wulffern/tt06-sar/media/adcs.pdf

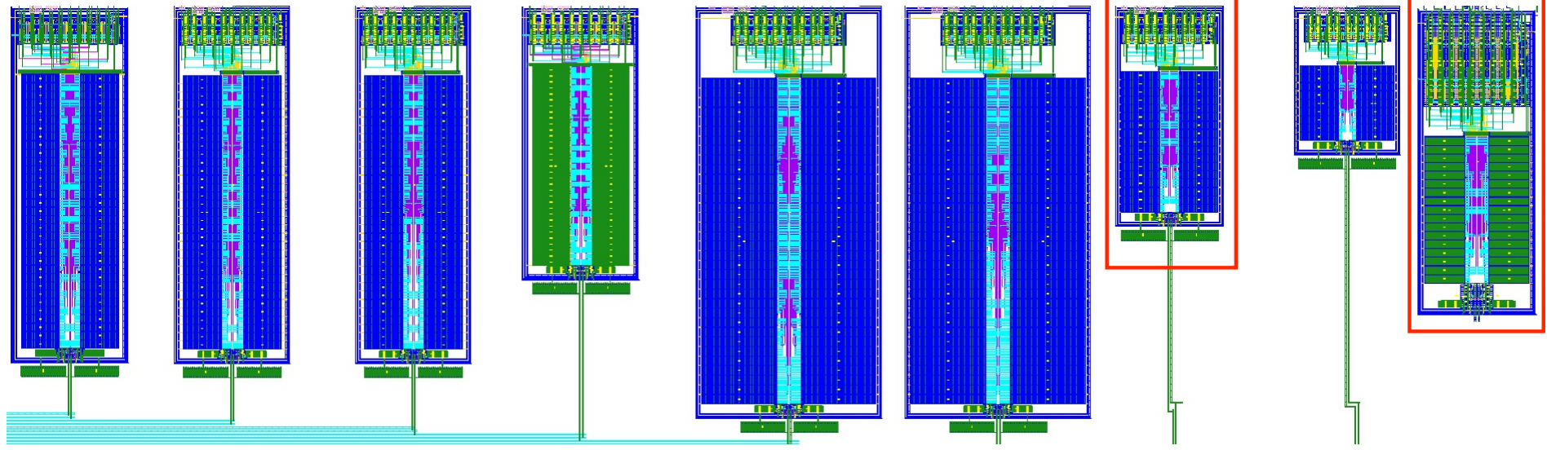
[picture p7: figure]

10-bit Prototype 14-08-2014 10-bit second order compensated CDAC

10-bit common centroid CDAC

10-bit f**k recommended DRC rules 11-bit second order compensated CDAC 11-bit common centroid CDAC

9-bit
8-bit

9-bit IO voltage
