wulffern/tt06-sar/media/cnano.pdf

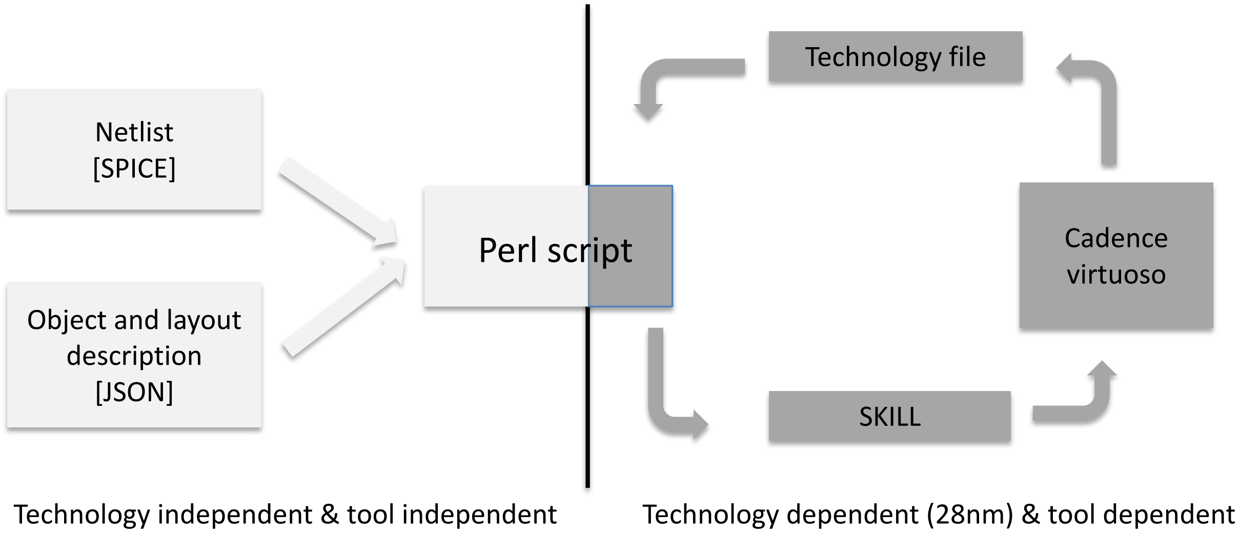
[picture p8: page 1]

Netlist
[SPICE]

Object and layout
description
[JSON]

Technology file

SKILL

Cadence
virtuoso

Technology independent & tool independent Technology dependent (28nm) & tool dependent

### Perl script
