wulffern/tt06-sar/docs/sar.pdf

# 8-bit SAR ADC on Tiny Tapeout

# tt06-sar (https://github.com/wulffern/tt06-sar)

Carsten Wulff 2024 | 1

# Goal

# Walk you through tt06-sar, and the steps necessary to tapeout on TinyTapeout

Carsten Wulff 2024 | 2

# Idea

Carsten Wulff 2024 | 3

# Trigger (2009)

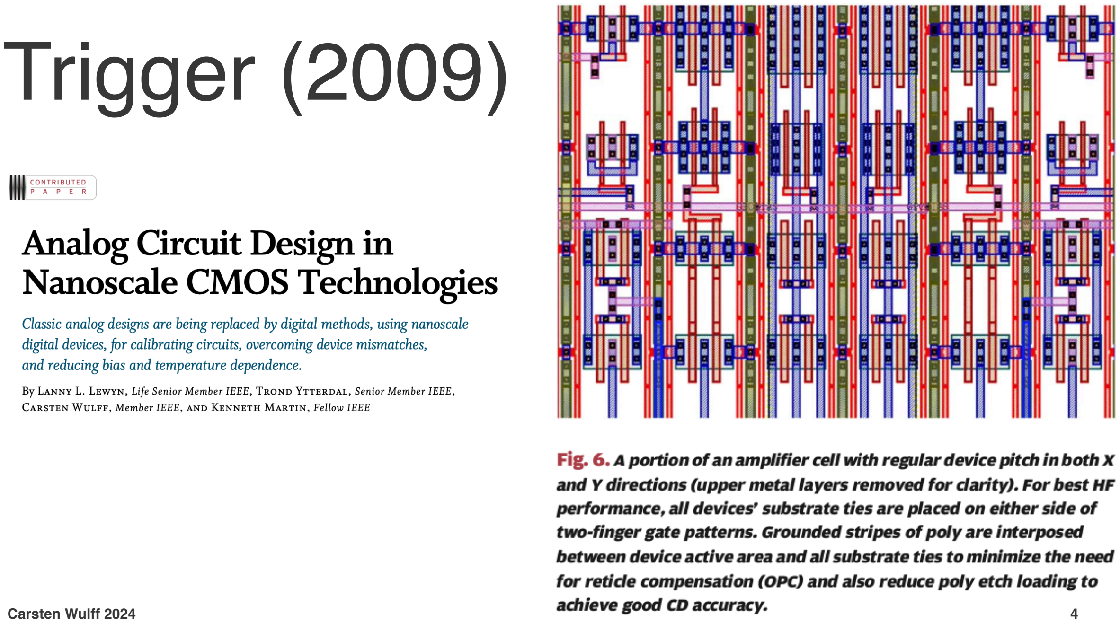
[picture p11: page 4]

Carsten Wulff 2024 | 4

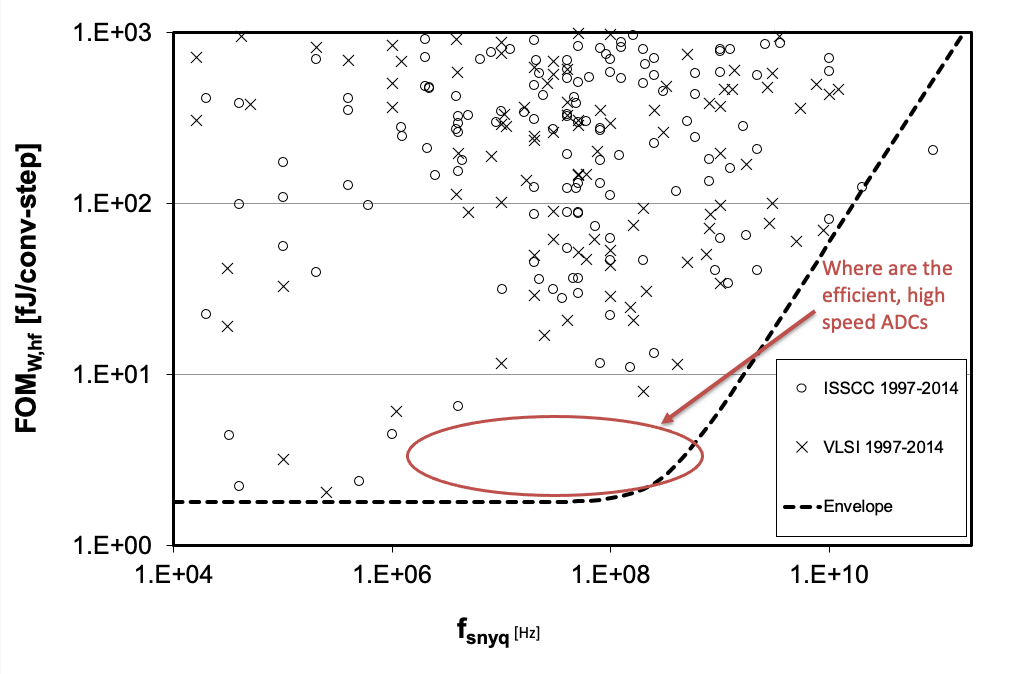
[picture p12: figure]

# Problem (2014)

Carsten Wulff 2024 | 5

# Circuit

Carsten Wulff 2024 | 6

### SAR Logic

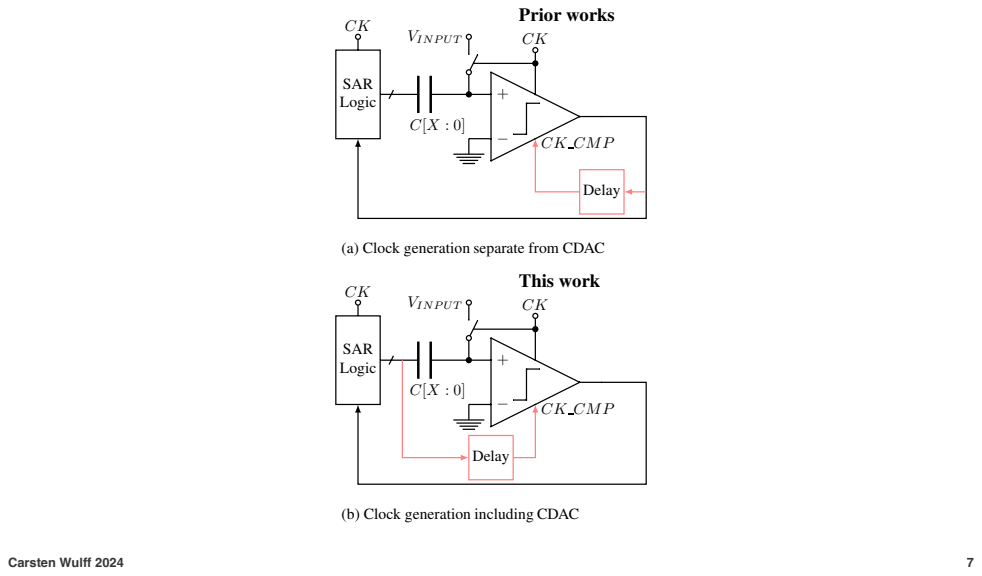
[picture p13: page 7]
Prior works; VINPUT; CK CMP; Delay; This work; SAR Logic; Carsten Wulff 2024

(a) Clock generation separate from CDAC

(b) Clock generation including CDAC

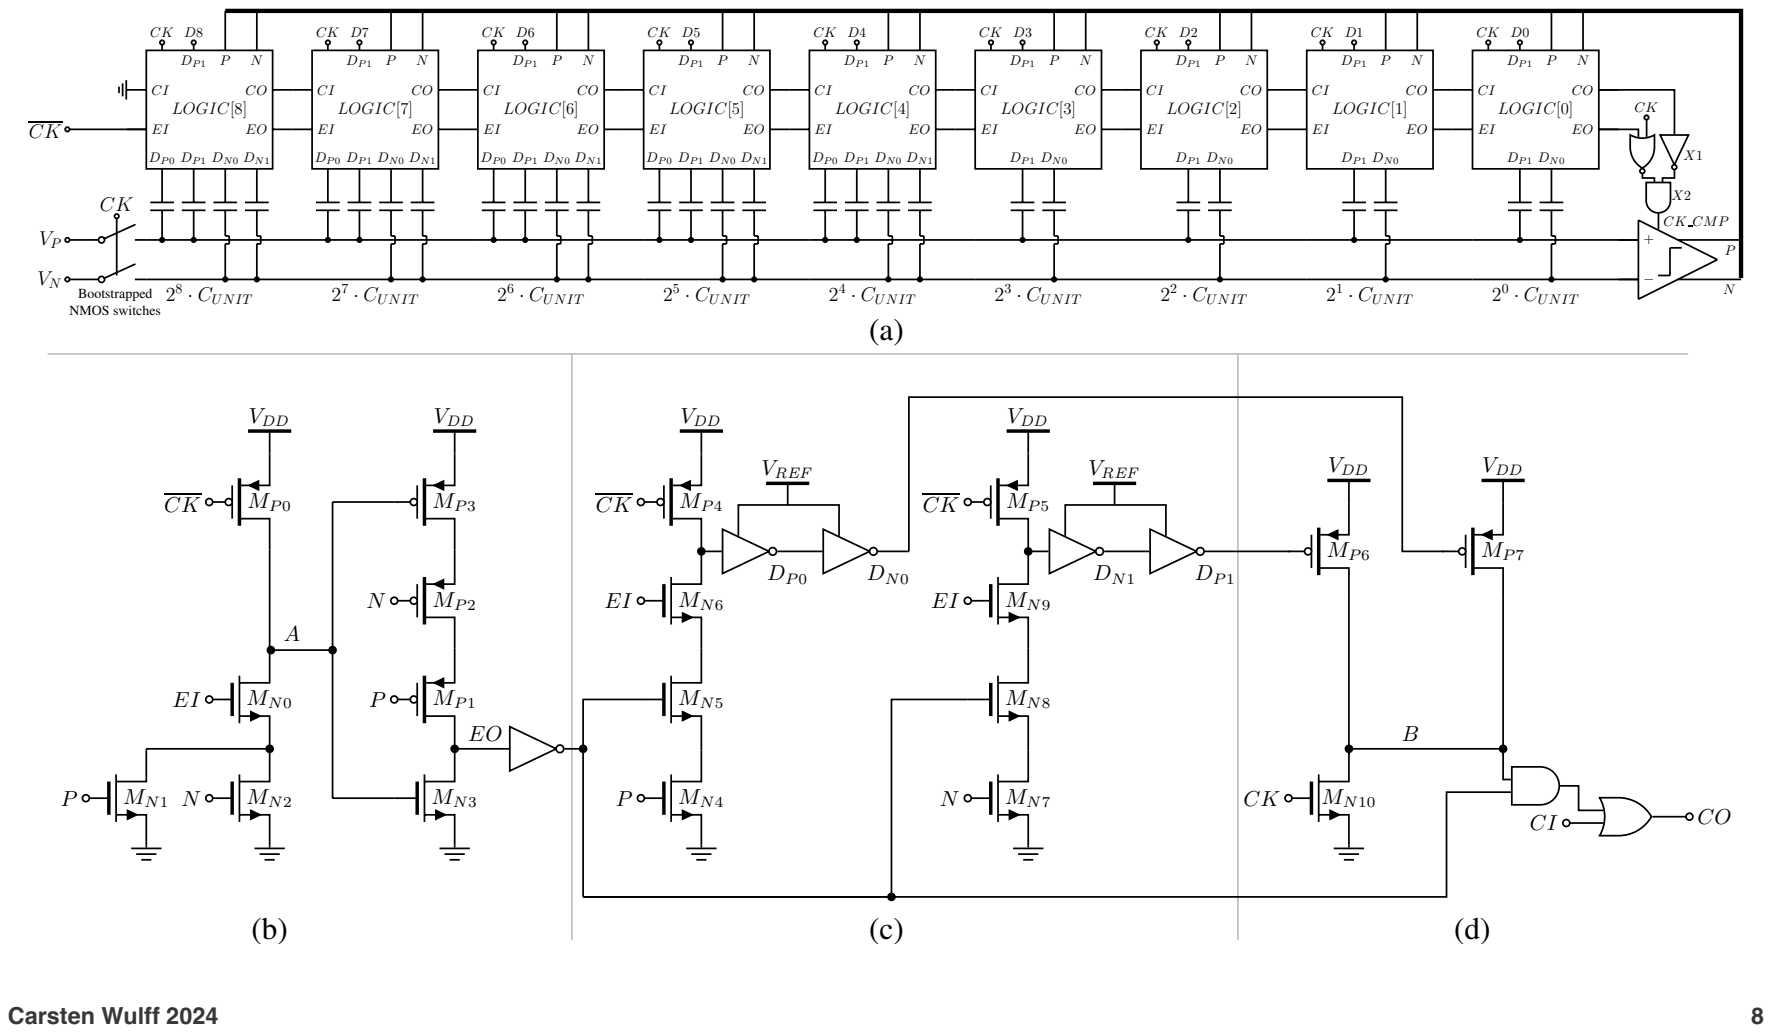
[picture p14: page 8]

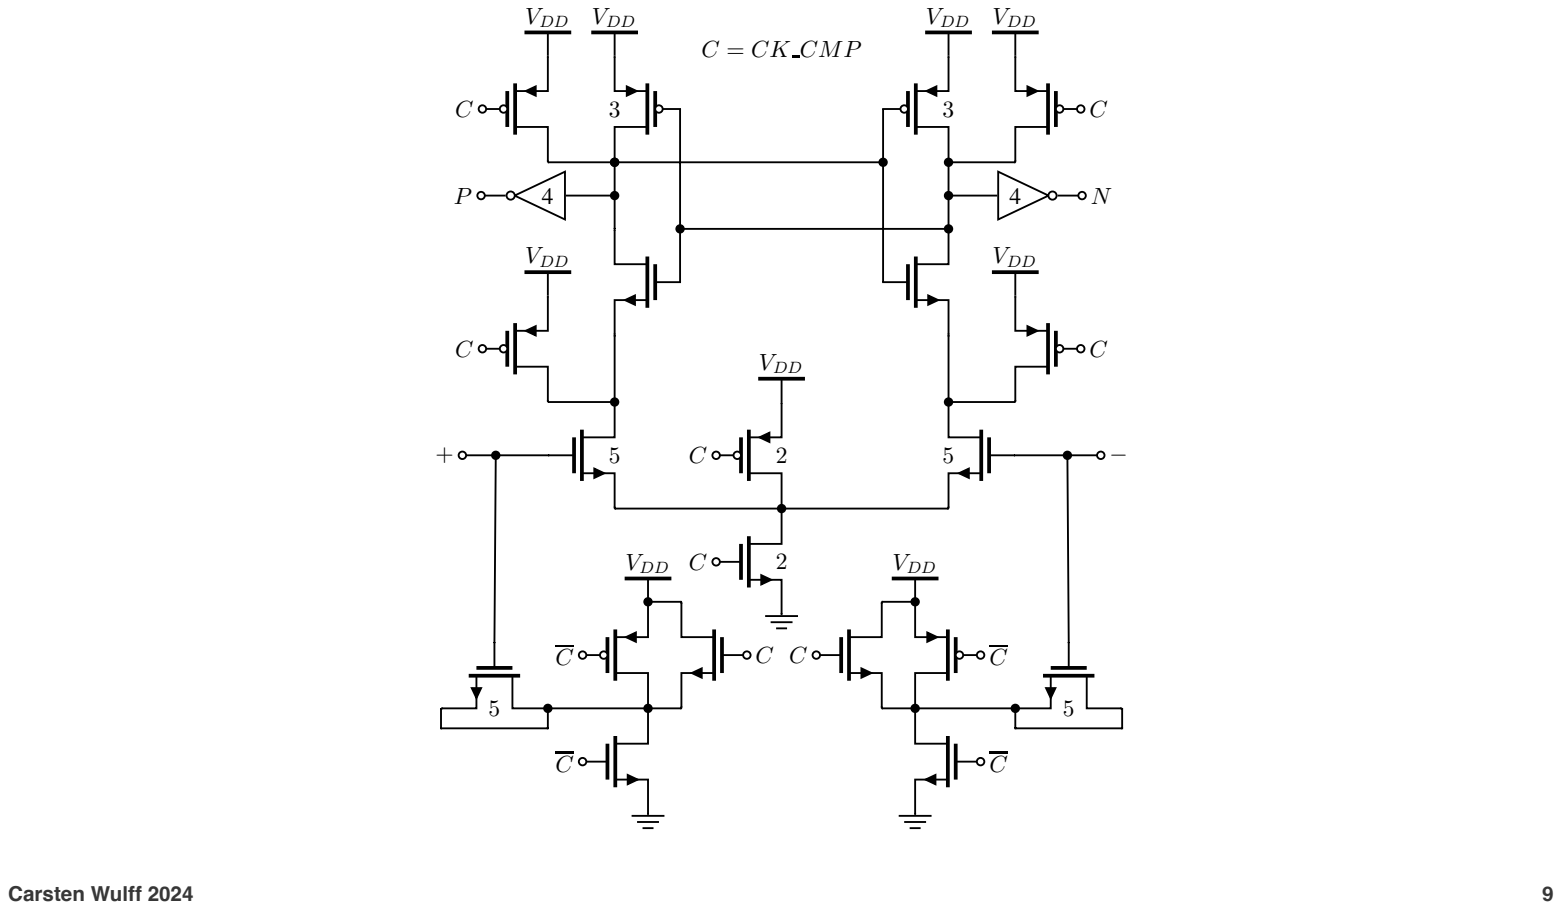
[picture p15: page 9]
C = CK CMP; VDD; Carsten Wulff 2024

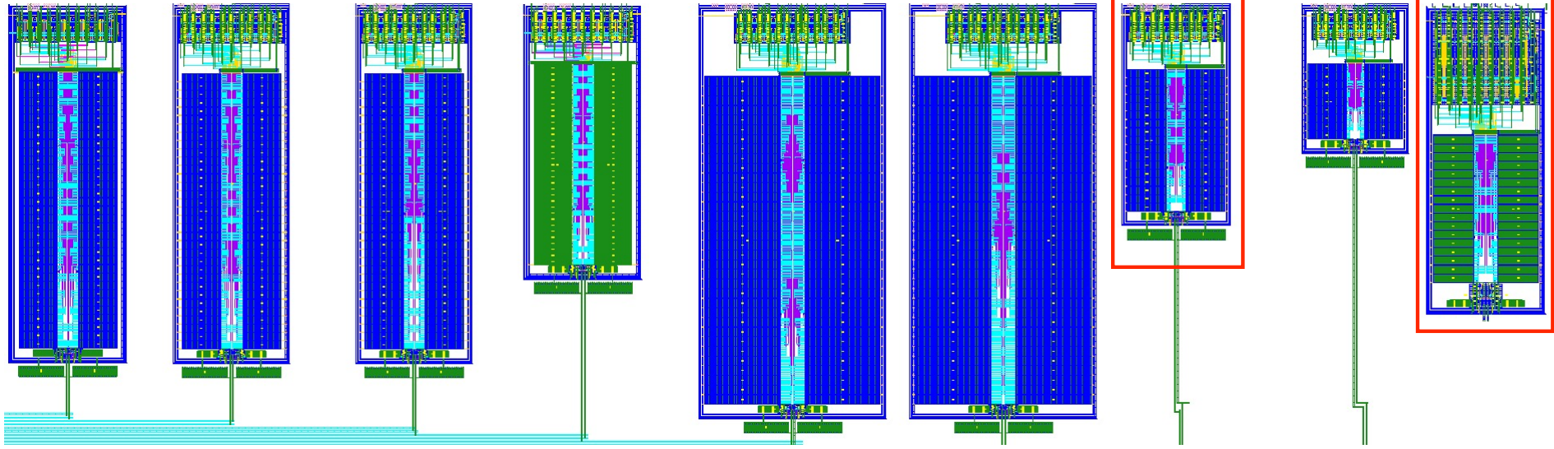
[picture p16: figure]

# 10-bit Prototype 14-08-2014 10-bit second order compensated CDAC

# 10-bit common centroid CDAC

# 10-bit f**k recommended DRC rules 11-bit second order compensated CDAC 11-bit common centroid CDAC

# 9-bit 8-bit

# 9-bit IO voltage

Carsten Wulff 2024 | 10

Weaver [5] | Harpe [9] | Patil [10] | Liu [11] | This work
Technology (nm) | 90 | 90 | 28 FDSOI | 28 | 28 FDSOI
Fsample (MS/s) | 21 | 2 | No sampling | 100 | 2 | 20

# Core area (mm²

) | 0.18 | 0.047 | 0.0032 | 0.0047 | 0.00312
SNDR (dB) | 34.61 | 57.79 | 40 | 64.43 | 46.43 48.84
SFDR (dBc) | 40.81 | 72.33 | 30 | 75.42 | 61.72 63.11
ENOB (bits) | 5.45 | 6.7 - 9.4 | 6.35 | 10.41 | 7.42 | 7.82
Supply (V) | 0.7 | 0.7 | 0.65 | 0.9 | 0.47 | 0.69
Pwr (µW) | 1110 | 1.64 -3.56 | 24 | 350 | 0.94 | 15.87
Compiled | Yes | No | No | No | | Yes
FoM (fJ/c.step) | 838 | 2.8 - 6.6 | 3.7 | 2.6 | 2.7 | 3.5
Carsten Wulff 2024 | 11

# Compilation

Carsten Wulff 2024 | 12

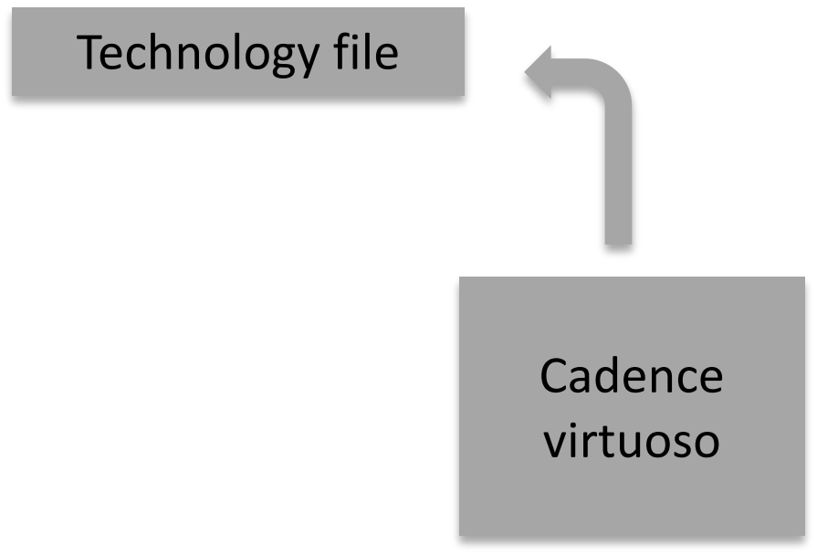
[picture p17: figure]
Technology file; Cadence virtuoso
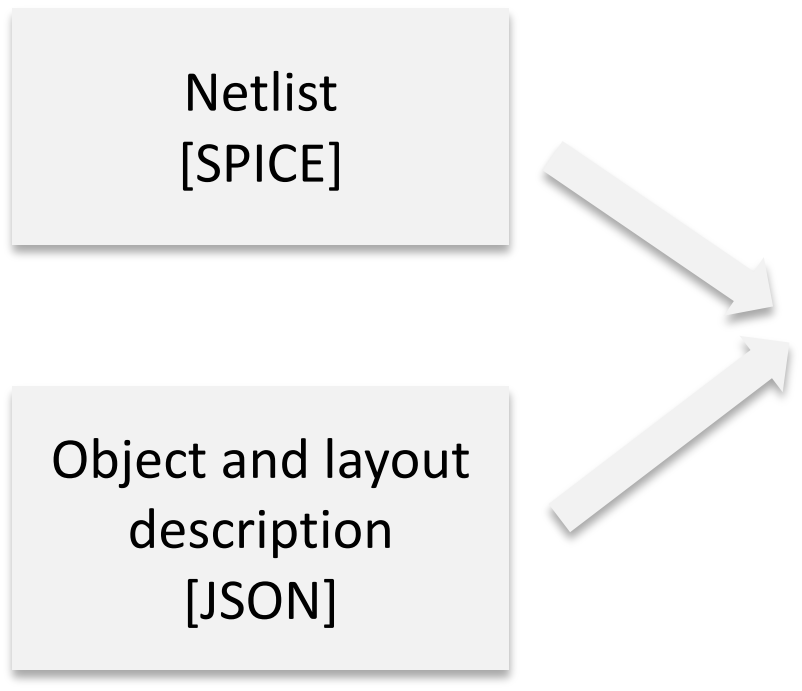
[picture p18: figure]
Netlist [SPICE]; Object and layout description [JSON]

# SKILL

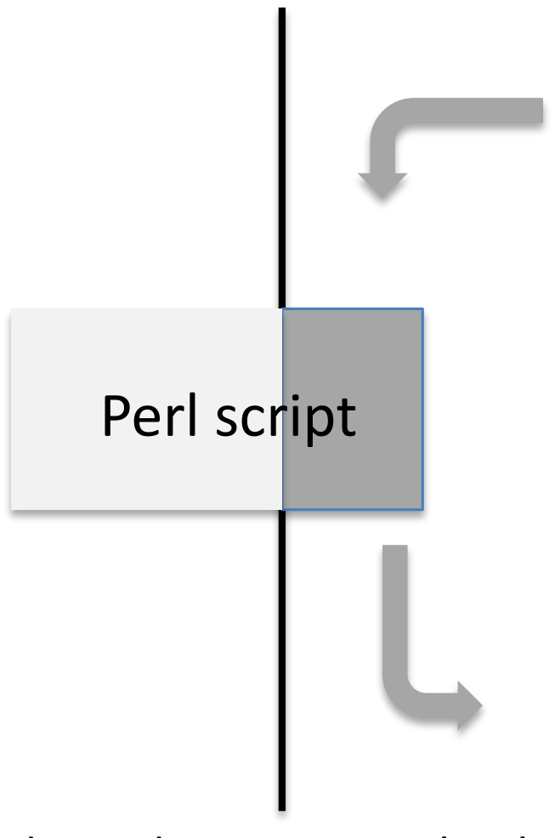
[picture p19: figure]
Perl script

Technology independent & tool independent | Technology dependent (28nm) & tool dependent
16 k Perl lines. Ported to C++ for speed | ciccreator (https://github.com/wulffern/ciccreator)
Carsten Wulff 2024 | 13

{ "name" : "DMOS" ,
"class" : "Gds::GdsPatternTransistor", "yoffset": -0.5,
"widthoffset" : -1,

### "fillCoordinatesFromStrings" : [

[ | "OD",
| "------------------xxxx",
| "----xCxC----------xCxC",
| "----xxxx----------xxxx",
| "----xCxC----------xCxC",
| "------------------xxxx"
],
[ | "PO",
| "-mmmmmmmmmmmmm--------",
| "----------------------",
| "-mmmmmmmmmmcxc--------",
| "----------------------",
| "-mmmmmmmmmmmmm--------"
],
[ | "M1",

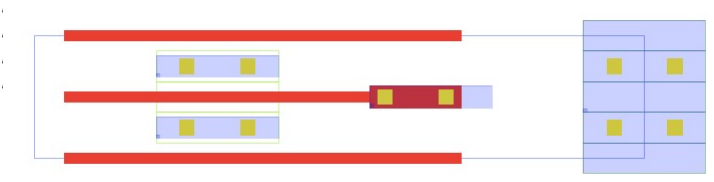
[picture p20: figure]

| "------------------xxxx",
| "----wDww----------xxxx",
| "-----------wGww---xBxx",
| "----wSww----------xxxx",
| "------------------xxxx"
]
]
}

# - Structure and any other property is described in JSON (JavaScript Object Notation) - “name” is the name of the cell - “class” defines which object to use - All other classes in the JSON object refer to

## object methods (there are some special functions, but more on that

## later)

# - Convert a text string into a layout drawing - c = contact - C = center contact on rectangle left edge - x = fill rectangle - m = use minimum length poly - w = use “width” from techfile - DGSB = add ports

Carsten Wulff 2024 | 14

| | Vertical Grid
D | | | Horizontal Grid
| G | | | B

S

OD | PO | M CO | 1
Carsten Wulff 2024 | 15

{ "name": "IVX1_CV" ,
"symbol" : "inv",
"class" : "Layout::LayoutDigitalCell",

## "spice" : [

".subckt IVX1_CV A Y AVDD AVSS" , "MN0 Y A AVSS AVSS NCHDL",
"MP0 Y A AVDD AVSS PCHDL", ".ends IVX1_CV”],

## "addSchematicCoordinates" : {

"MN0" : [ 0.25, 0, "R0"],

## "MP0" : [0.25, 0.5, "R0”]

},

## "beforeRoute" : { "addDirectedRoutes" : [ ["M1","Y","MN:D-|--MP:D"], ["PO","A","MN:G-MP:G"] ]

},

## "afterRoute" : { "addPortOnRects" : [ ["A","M1", "MN0:G"] , ["Y", "M1", "MN0:D"]]

}
}

## What symbol to use, defaults to templates/skill/<name>.il LayoutDigitalCell has extra functions for digital cells, and will add

power rails.

## Connectivity defined by SPICE. SPICE subcircuit can be read from a separate file

## Help the schematic generator to place transistors so it’s easier to read schematics

## Find rectangle on device MN:D, and route in M1 to rectangle MP:D

using a left, up or down, left pattern.

## Add port for A on the gate of MN0

Carsten Wulff 2024 | 16

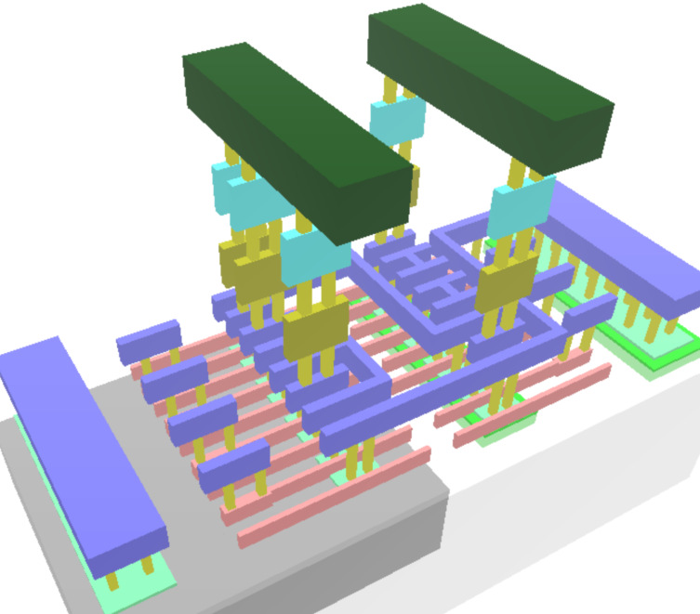
[picture p21: figure]
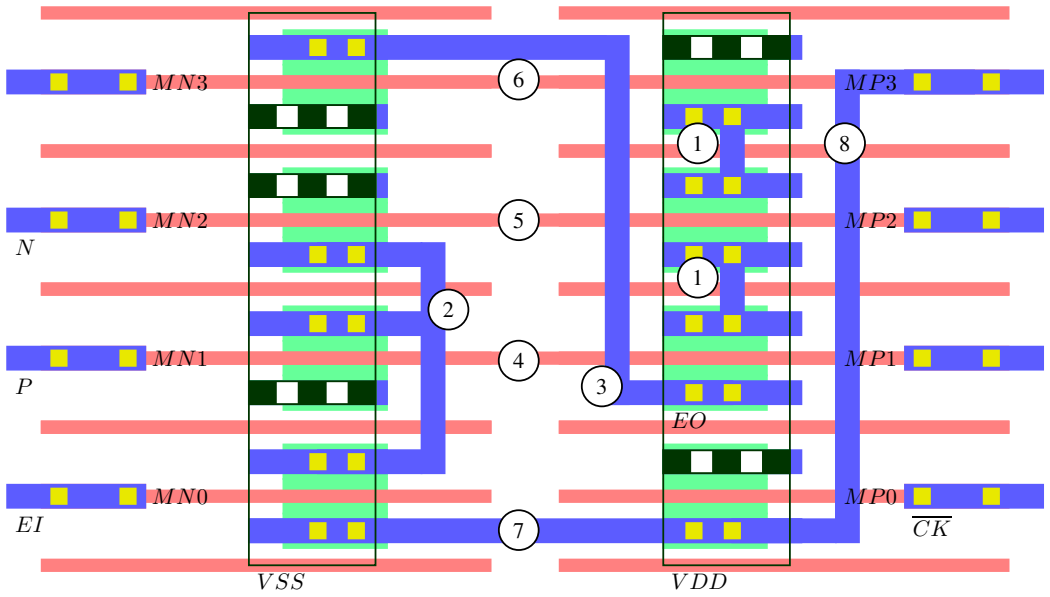
[picture p22: figure]

(d)

(a) (c)

{ "name": "SAREMX1_CV", "class" : "Layout::LayoutDigitalCell", "addConnectivityRoutes": [

["M1","N1|N2","||",""], | 1
["M1","N3","-|",""], | 2
["M1","EO","--|-","onTopR"] | 3
],
"addDirectedRoutes" : [
["PO","P","MN1:G-MP1:G"], | 4
["PO","N","MN2:G-MP2:G"], | 5
["PO","A","MN3:G-MP3:G"], | 6
["M1","A","MN0:S-MP0:S"], | 7
["M1","A","MP0:S-|--MP3:G"] | 8
]
}
}

(b)

.SUBCKT SAREMX1_CV P | N EI EO CK_N AVDD AVSS
MN0 N3 | EI | A | AVSS | NCHDL
MN1 N3 | P | AVSS AVSS | NCHDL
MN2 AVSS N | N3 | AVSS | NCHDL
MN3 EO | A | AVSS AVSS | NCHDL
MP0 AVDD CK_N A | AVSS | PCHDL
MP1 N2 | P | EO | AVSS | PCHDL
MP2 N1 | N | N2 | AVSS | PCHDL
MP3 AVDD A | N1 | AVSS | PCHDL
.ENDS
OD | PO | M CO | 1 | M2 | M3 | M4
Carsten Wulff 2024 | 17

# Since then

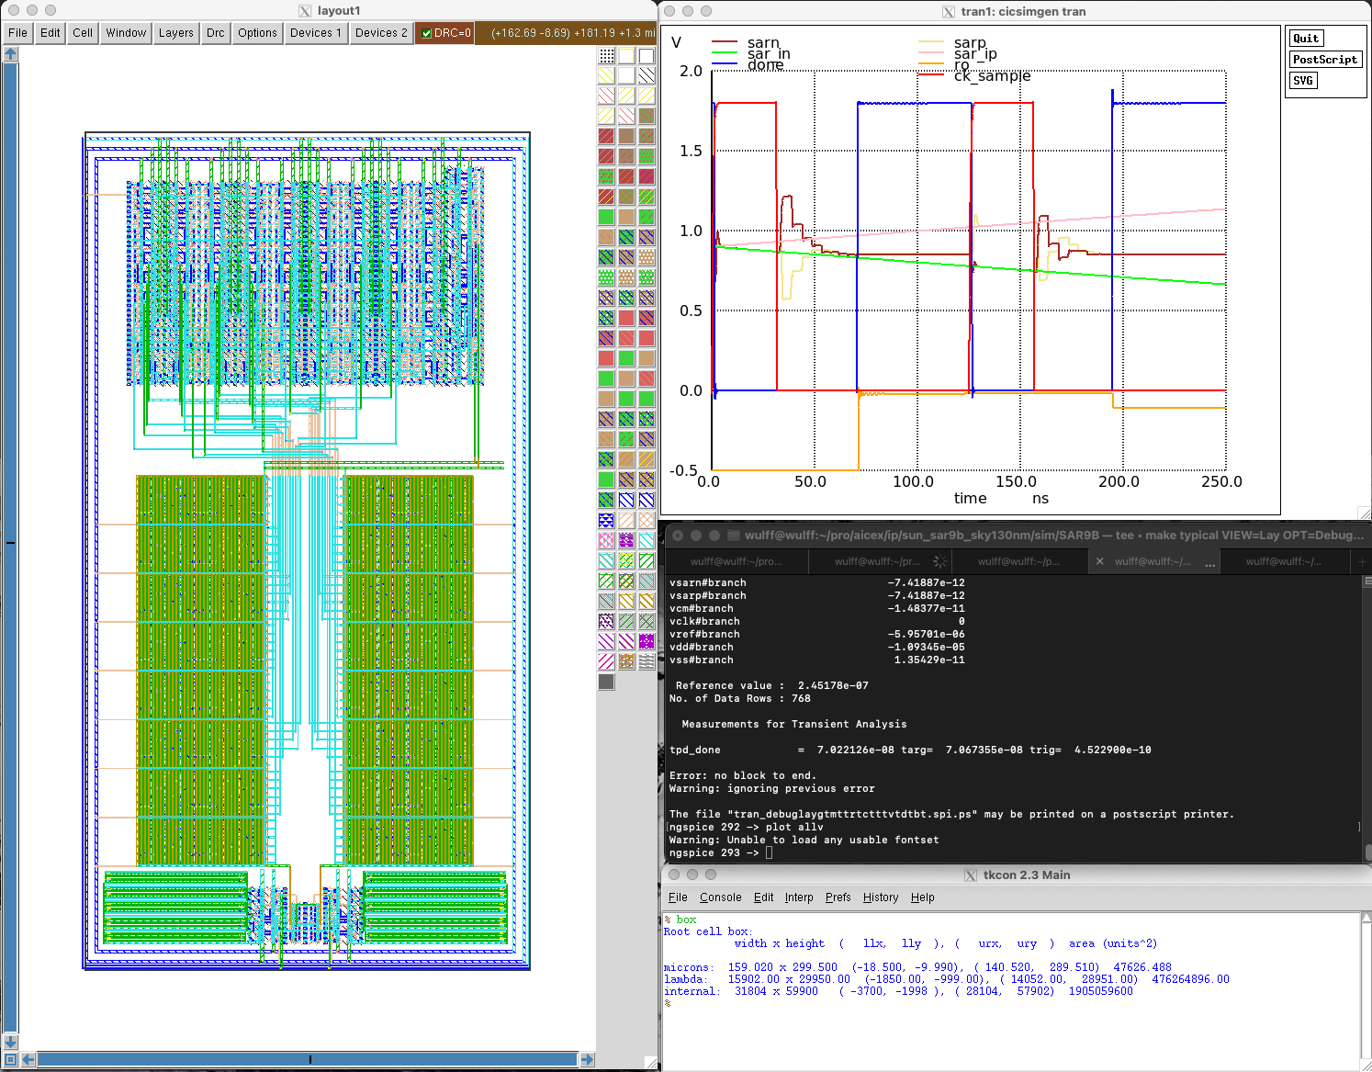
[picture p23: figure]

# Measured: 28 nm FDSOI, 55 nm Ported: 22 nm FDSOI, 22 nm, 28 nm, 65 nm, 130 nm

# 2022: There is an open source port to skywater 130nm! wulffern/sun_sar9b_sky130nm (https://github.com/wulffern/sun_sar9b_sky130nm)

Carsten Wulff 2024 | 18

# Super simple transistor was a good choice for portability

Carsten Wulff 2024 | 19

//sky130
{ "name" : "DMOS_BULKN" ,
"class" : "Gds::GdsPatternTransistor"

,
"abstract" :

1

,
"yoffset": -0.5

,
"widthoffset" : -0.5

,
"fillCoordinatesFromStrings" : [
[ | "OD" ,
| "-------------------"

,
| "----xxx------------"

,
| "----xxx------------"

,
| "----xxx------------"

,
| "-------------------"
],
[ | "M1" ,
| "----------------xxx"

,
| "----wDw---------xxx"

,
| "----------wGw---xBx"

,
| "----wSw---------xxx"

,
| "----------------xxx"
],
[ "NDIFFC"

,
| "-------------------"

,
| "----LTR------------"

,
| "-------------------"

,
| "----LTR------------"

,
| "-------------------"
]
] }

//28nm FDSOI
{ "name" : "DMOS" ,
"class" : "Gds::GdsPatternTransistor"

,
"yoffset": -0.5

,
"type": "pch"

,
"widthoffset" : -1

,
"fillCoordinatesFromStrings" : [ [ "OD"

,
"------------------xxxx"

,
"----xxK-----------xCxC"

,
"----xxx-----------xxxx"

,
"----xxK-----------xCxC"

,
"------------------xxxx"
],
[ "PO"

,
"-mmmmmmmmmmmmm--------"

,
"----------------------"

,
"-mmmmmmmmmmcxc--------"

,
"----------------------"

,
"-mmmmmmmmmmmmm--------"
],
[ "M1"

,
"------------------xxxx"

,
"----wDww----------xxxx"

,
"-----------wGww---xBxx"

,
"----wSww----------xxxx"

,
"------------------xxxx"
]
],
"afterNew" : {
"copyColumns" :[
{ "count" :

0, "offset" :

4

,"length" :

4

}
]
} }
Carsten Wulff 2024 | 20

# 2016 (Perl compiler)

{ "name": "SARCMPHX1_CV",
"description" : "Half a strong-arm comparator", "class" : "Layout::LayoutDigitalCell", "setYoffsetHalf" : "" ,
"rows" : 7,
"beforeRoute" : {
"addDirectedRoutes" : [ ["PO","VMR","MN6:G-MP6:G"], ["M1","VMR","MP4:G||MP6:G"], ["M1","CI","MN1:G||MN5:G"], ["M1","N2","MN1:D,MN3:D,MN5:D-|--MP1:D"], ["M1","N1","MN0:D,MN2:D|-MN4:D"], ["M1","N1","MN0:D-|--MP0:S"], ["M1","CO","MP3:D,MP5:D--|-MN6:D"], ["PO","CK","MN0:G-MP0:G"], ["M1","CK","MP0:G,MP1:G-|MP3:G"], ["M4","NC","MP2$:D--|--MP2:G"]
]
},
"afterRoute" : {
"addPortOnRects" : [ ["AVDD","M4" ], ["N1","M1","MN4:D"],
["N2","M1","MN5:D" ]]
}
}

# 2022 (C++ compiler)

{ "name": "SARCMPHX1_CV",
"description" : "Half a strong-arm comparator", "class" : "Layout::LayoutDigitalCell", "setYoffsetHalf" : 1 ,
"rows" : 7,
"meta" : {
"noSchematic" : true
},
"decorator" : [
{"ConnectSourceDrain" : ["M1","||",""]}
],
"beforeRoute" : {
"addDirectedRoutes" : [ ["PO","VMR","MN6:G-MP6:G"], ["M1","VMR","MP4:G||MP6:G"], ["M1","CI","MN1:G||MN5:G"], ["M1","N2","MN1:D,MN3:D,MN5:D-|--MP1:D"], ["M1","N1","MN0:D,MN2:D|-MN4:D"], ["M1","N1","MN0:D-|--MP0:S"], ["M1","CO","MP3:D,MP5:D--|-MN6:D"], ["PO","CK","MN0:G-MP0:G"], ["M1","CK","MP0:G,MP1:G-|MP3:G"], ["M4","NC","MP2$:D-|--MP2:G"]
]
},
"afterRoute" : {
"addPortOnRects" : [["BULKP","M1"], ["BULKN","M1"],
["AVDD","M4" ],
["N1","M1","MN4:D"],
["N2","M1","MN5:D" ]]
}
}
Carsten Wulff 2024 | 21

# Usage is hard, requires a new type of analog designer/programmer

Carsten Wulff 2024 | 22

# Architecture

# Hand Analysis

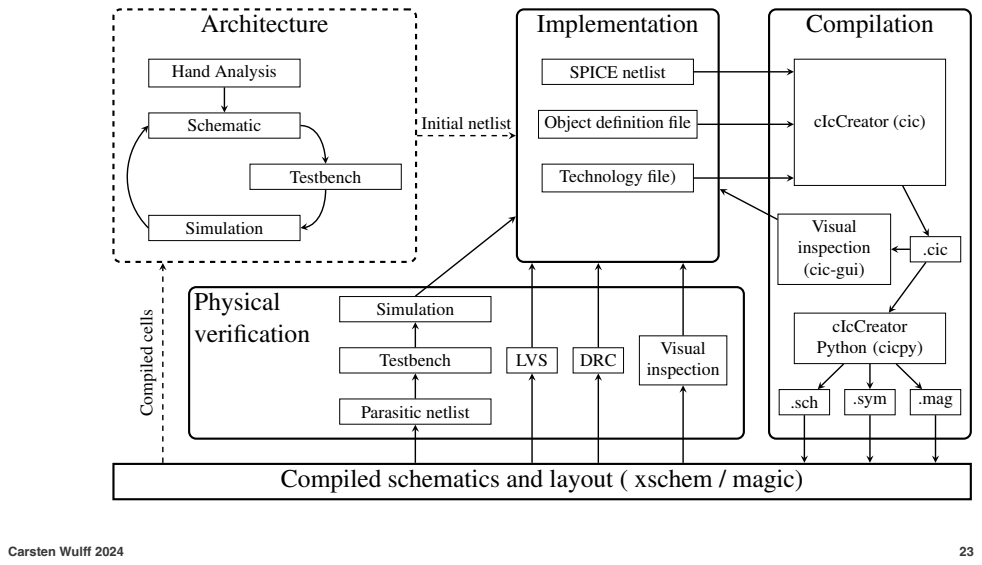
[picture p24: page 23]
Schematic; Testbench; Simulation; Implementation; SPICE netlist; Technology file); Compilation; cIcCreator (cic); .cic; cIcCreator Python (cicpy); Visual inspection (cic-gui); .sch; .sym; .mag; Physical verification; Parasitic netlist; LVS; DRC; Visual inspection; Initial netlist; Compiled cells; Carsten Wulff 2024

Object definition file

Compiled schematics and layout ( xschem / magic)

# ciccreator (https://github.com/wulffern/ciccreator)

# ciccreator docs (https://analogicus.com/ciccreator/)

# cicpy (https://github.com/wulffern/cicpy)

Carsten Wulff 2024 | 24

# [1] A Compiled 9-bit 20-MS/s 3.5-fJ/ conv.step SAR ADC in 28-nm FDSOI for

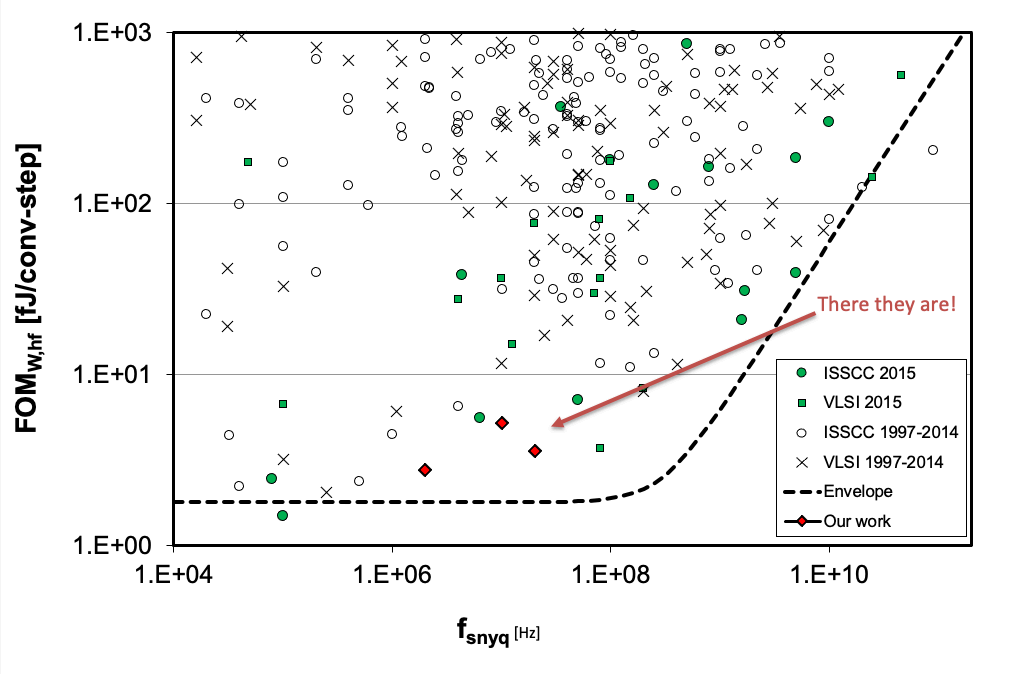
[picture p25: figure]

# Bluetooth Low Energy Receivers (https://ieeexplore.ieee.org/document/7906479)

# [2] A 68 dB SNDR Compiled Noise-Shaping SAR ADC With On-Chip CDAC Calibration (https://ieeexplore.ieee.org/document/9056925)

Carsten Wulff 2024 | 25

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

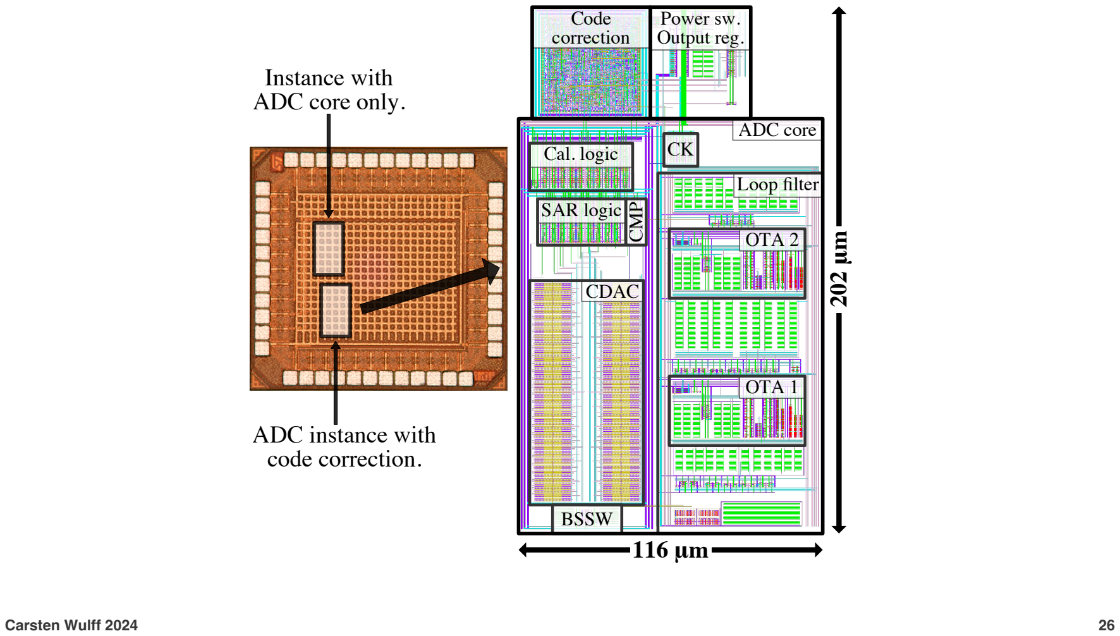
[picture p26: page 26]

# Things I want to show

# - Tiny Tapeout Process

# - Schematics

# - Layout

# - DRC/LVS

# - Parasitic extraction

# - Verification plan and simulations

# - Delivery

# - Iteration

Carsten Wulff 2024 | 27

# Thanks!

Carsten Wulff 2024 | 28
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
