wulffern/tt06-sar/ip/tt06_sar_sky130nm/sim/TT06_SAR/TT06_SAR.md

TT06_SAR

### Dynamic parameters (tran)

Verify response to a sinusoid input signal

|**Name**|**Parameter**|**Description**| |**Min**|**Typ**|**Max**| Unit|
|:---|:---|:---|---:|:---:|:---:|:---:| ---:|
|**Maximum operating frequency**|**maxfreq\_MHz** || **Spec**  | **4.00** | **8.00** | **20.00** | **MHz** |
| | | |<a href='results/tran_Lay_typical.html'>Lay_typ</a>| | 11.36 |  | |
| | | |<a href='results/tran_Lay_slow.html'>Lay_slow</a>|4.42 | 5.73 | 7.04 | |
| | | |<a href='results/tran_Lay_fast.html'>Lay_fast</a>|17.24 | 17.55 | 17.86 | |
| | | |<a href='results/tran_Lay_mc.html'>Lay_3std</a>|11.10 | 11.34 | 11.58 | |
|**Signal to noise and distortion ratio**|**SNDR** || **Spec**  | **38.0** | **45.0** | **50.0** | **dB** |
| | | |<a href='results/tran_Lay_typical.html'>Lay_typ</a>| | 44.6 |  | |
| | | |<a href='results/tran_Lay_slow.html'>Lay_slow</a>|44.7 | 45.7 | 46.6 | |
| | | |<a href='results/tran_Lay_fast.html'>Lay_fast</a>|44.2 | 45.0 | 45.8 | |
| | | |<a href='results/tran_Lay_mc.html'>Lay_3std</a>|43.9 | 45.2 | 46.5 | |
|**Signal to noise and distortion ratio (FS)**|**SNDR\_FS** || **Spec**  | **42.0** | **45.0** | **50.0** | **dB** |
| | | |<a href='results/tran_Lay_typical.html'>Lay_typ</a>| | 47.7 |  | |
| | | |<a href='results/tran_Lay_slow.html'>Lay_slow</a>|47.3 | 48.3 | 49.2 | |
| | | |<a href='results/tran_Lay_fast.html'>Lay_fast</a>|47.8 | 48.6 | 49.4 | |
| | | |<a href='results/tran_Lay_mc.html'>Lay_3std</a>|47.0 | 48.3 | 49.6 | |
|**Spurious free dynamic range**|**SFDR** || **Spec**  | **40.0** | **50.0** | **70.0** | **dBc** |
| | | |<a href='results/tran_Lay_typical.html'>Lay_typ</a>| | 49.7 |  | |
| | | |<a href='results/tran_Lay_slow.html'>Lay_slow</a>|50.5 | 52.0 | 53.5 | |
| | | |<a href='results/tran_Lay_fast.html'>Lay_fast</a>|49.1 | 52.0 | 54.9 | |
| | | |<a href='results/tran_Lay_mc.html'>Lay_3std</a>|45.9 | 52.1 | 58.2 | |
|**Effective number of bits**|**ENOB** || **Spec**  | **6.10** | **7.00** | **7.99** | **bits** |
| | | |<a href='results/tran_Lay_typical.html'>Lay_typ</a>| | 7.12 |  | |
| | | |<a href='results/tran_Lay_slow.html'>Lay_slow</a>|7.14 | 7.29 | 7.44 | |
| | | |<a href='results/tran_Lay_fast.html'>Lay_fast</a>|7.05 | 7.19 | 7.32 | |
| | | |<a href='results/tran_Lay_mc.html'>Lay_3std</a>|7.00 | 7.22 | 7.43 | |
|**Effective number of bits (FS)**|**ENOB\_FS** || **Spec**  | **6.80** | **7.00** | **7.99** | **bits** |
| | | |<a href='results/tran_Lay_typical.html'>Lay_typ</a>| | 7.63 |  | |
| | | |<a href='results/tran_Lay_slow.html'>Lay_slow</a>|7.57 | 7.72 | 7.88 | |
| | | |<a href='results/tran_Lay_fast.html'>Lay_fast</a>|7.65 | 7.78 | 7.92 | |
| | | |<a href='results/tran_Lay_mc.html'>Lay_3std</a>|7.52 | 7.74 | 7.95 | |
|**Active current**|**iavdd** || **Spec**  | **30.0** | **50.0** | **70.0** | **uA** |
| | | |<a href='results/tran_Lay_typical.html'>Lay_typ</a>| | 48.0 |  | |
| | | |<a href='results/tran_Lay_slow.html'>Lay_slow</a>|44.7 | 46.1 | 47.5 | |
| | | |<a href='results/tran_Lay_fast.html'>Lay_fast</a>|49.2 | 54.4 | 59.6 | |
| | | |<a href='results/tran_Lay_mc.html'>Lay_3std</a>|47.7 | 48.1 | 48.4 | |
|**FFT input amplitude**|**AMP** || **Spec**  | **-6.00** | **-3.00** | **-0.20** | **dB** |
| | | |<a href='results/tran_Lay_typical.html'>Lay_typ</a>| | -3.12 |  | |
| | | |<a href='results/tran_Lay_slow.html'>Lay_slow</a>|-2.62 | -2.60 | -2.58 | |
| | | |<a href='results/tran_Lay_fast.html'>Lay_fast</a>|-3.62 | -3.60 | -3.59 | |
| | | |<a href='results/tran_Lay_mc.html'>Lay_3std</a>|-3.12 | -3.11 | -3.11 | |
|**Walden FOM**|**FOM\_FS** || **Spec**  | **50.00** | **100.00** | **200.00** | **fJ/step** |
| | | |<a href='results/tran_Lay_typical.html'>Lay_typ</a>| | 108.80 |  | |
| | | |<a href='results/tran_Lay_slow.html'>Lay_slow</a>|80.73 | 93.63 | 106.53 | |
| | | |<a href='results/tran_Lay_fast.html'>Lay_fast</a>|116.25 | 116.66 | 117.06 | |
| | | |<a href='results/tran_Lay_mc.html'>Lay_3std</a>|86.39 | 101.59 | 116.79 | |

### Power down (pwrdwn)

Check active and power down currents

|**Name**|**Parameter**|**Description**| |**Min**|**Typ**|**Max**| Unit|
|:---|:---|:---|---:|:---:|:---:|:---:| ---:|
|**Active current**|**iact** |ui_in[0] = 1. Clock running| **Spec**  | **30.0** | **50.0** | **70.0** | **uA** |
| | | |<a href='results/pwrdwn_Lay_typical.html'>Lay_typ</a>| | 41.7 |  | |
|**Off Current**|**ioff** |ui_in[0] = 0. Clock running| **Spec**  | **10.0** | **200.0** | **1000.0** | **nA** |
| | | |<a href='results/pwrdwn_Lay_typical.html'>Lay_typ</a>| | 167.6 |  | |
