wulffern/tt06-sar/media/harald_layout.pdf

### ,QVWDQFH ZLWK $'& FRUH RQO\

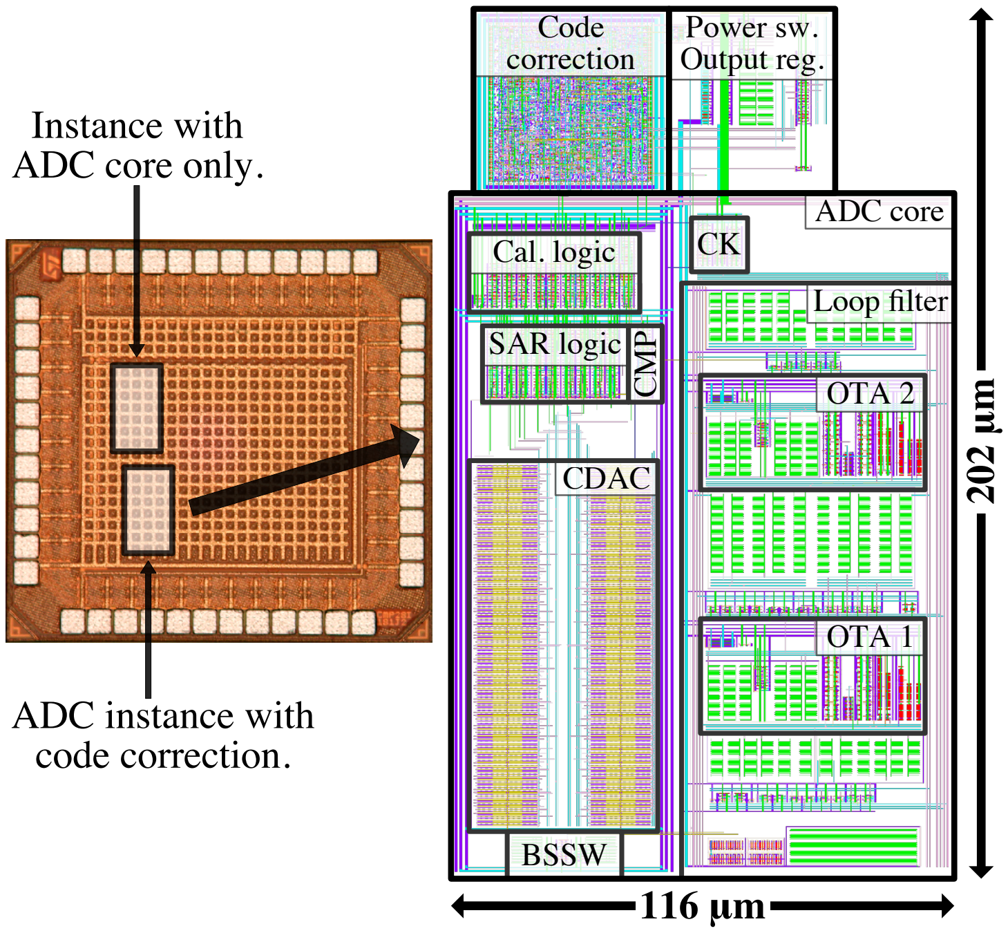
[picture p27: page 1]

&'$&

6$5 ORJLF

&DO ORJLF &.

/RRS ÀOWHU

27$

27$

&03

%66:
P

P

$'& FRUH

3RZHU VZ

2XWSXW UHJ &RGH
FRUUHFWLRQ

### $'& LQVWDQFH ZLWK FRGH FRUUHFWLRQ
