wulffern/tt06-sar/ip/tt06_sar_sky130nm/sim/TT06_SAR/tran_Lay_tfs.png

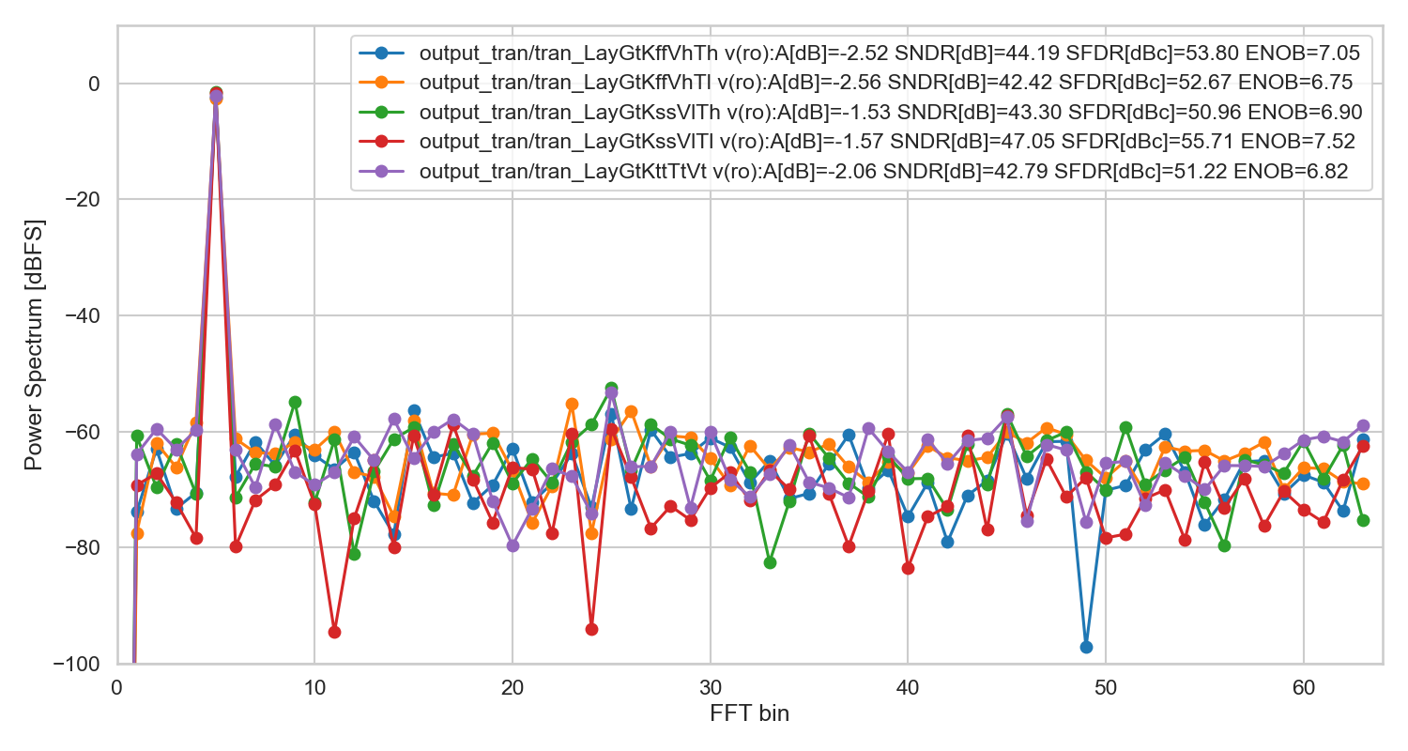
ip/tt06_sar_sky130nm/sim/TT06_SAR/tran_Lay_tfs.png
