wulffern/tt06-sar/media/fig_process.pdf

## Architecture

## Implementation

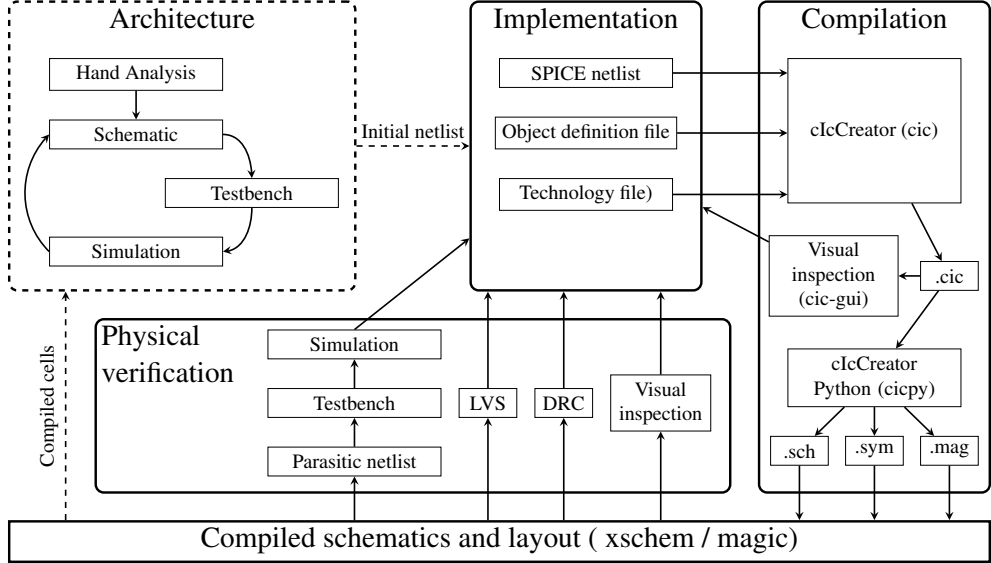
[picture p30: page 1]
Hand Analysis; Schematic; Testbench; Simulation; SPICE netlist; Technology file); Compilation; cIcCreator (cic); .cic; cIcCreator Python (cicpy); Visual inspection (cic-gui); .sch; .sym; .mag; Physical verification; Parasitic netlist; LVS; DRC; Visual inspection; Initial netlist; Compiled cells

Object definition file

Compiled schematics and layout ( xschem / magic)
