wulffern/tt06-sar/media/fig_sar_logic.pdf

CK

VP

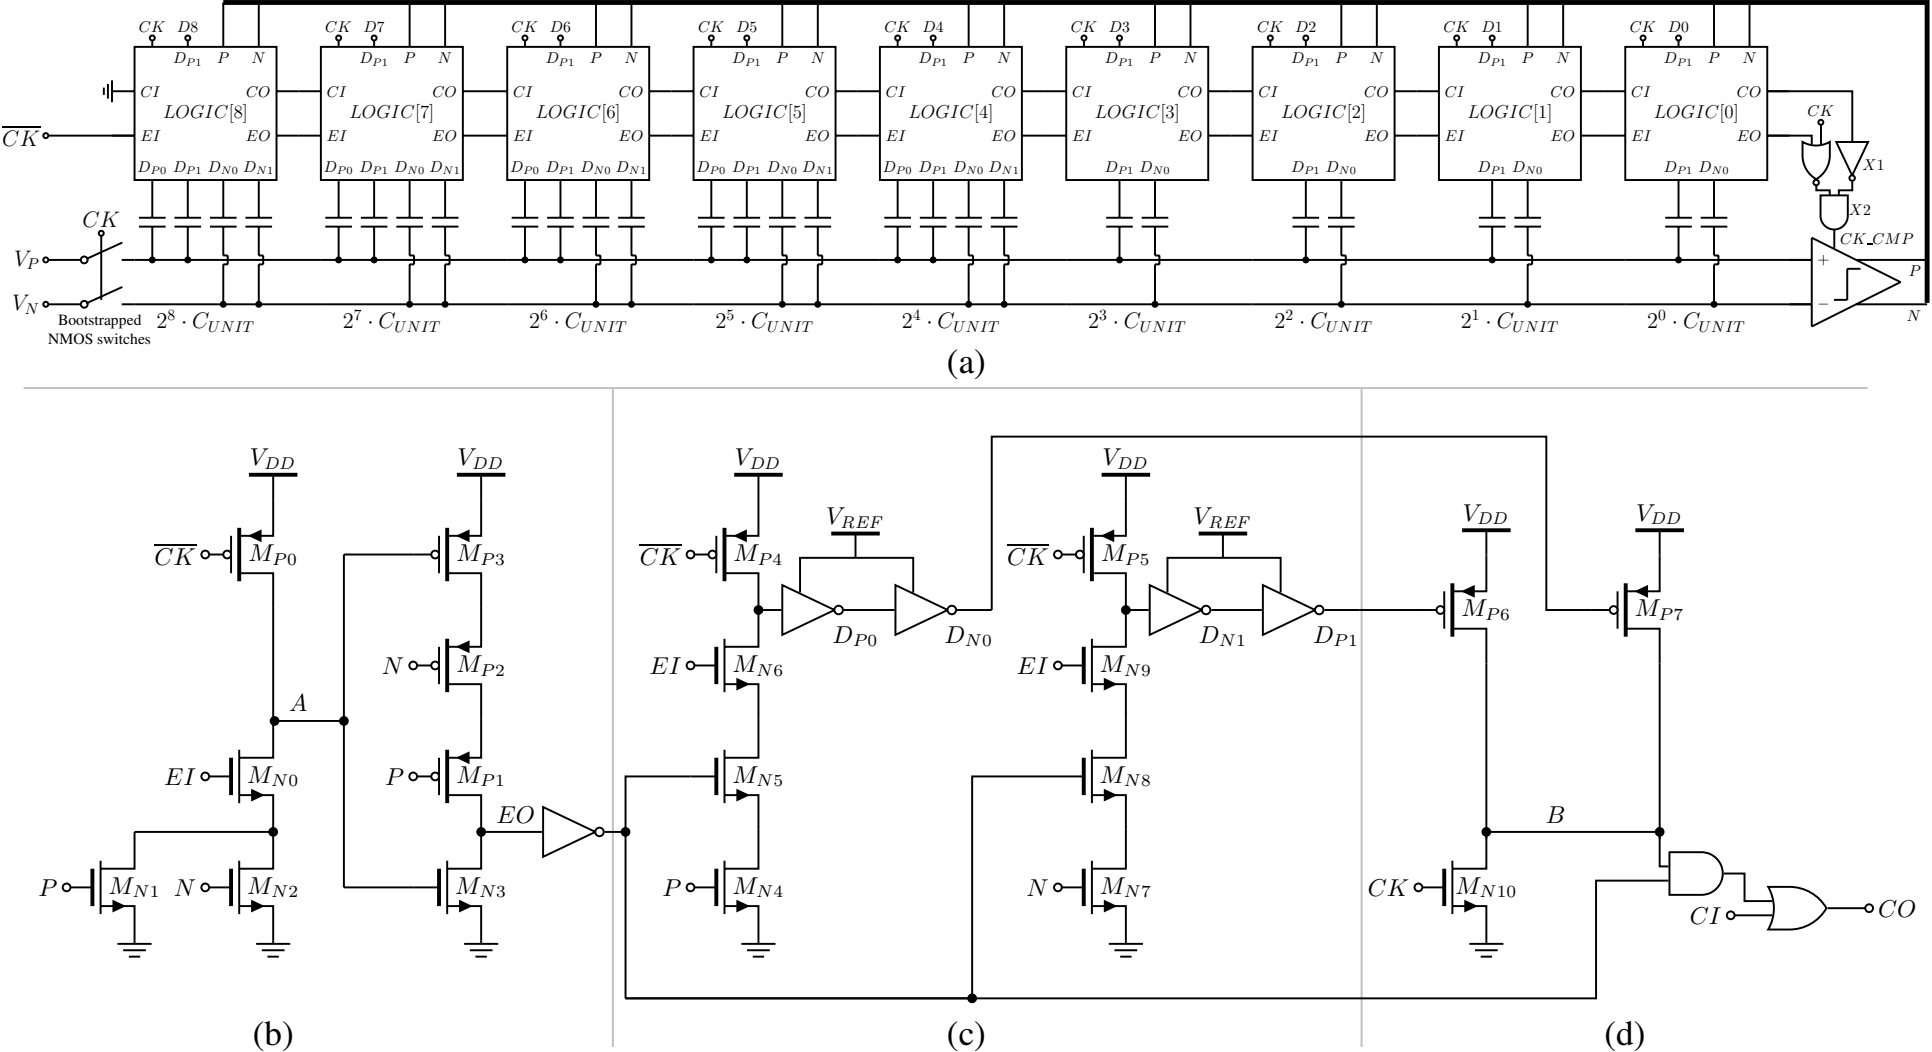
[picture p31: page 1]
