wulffern/tt06-sar/media/wulff_fig_comparator.pdf

## C = CK CMP

3

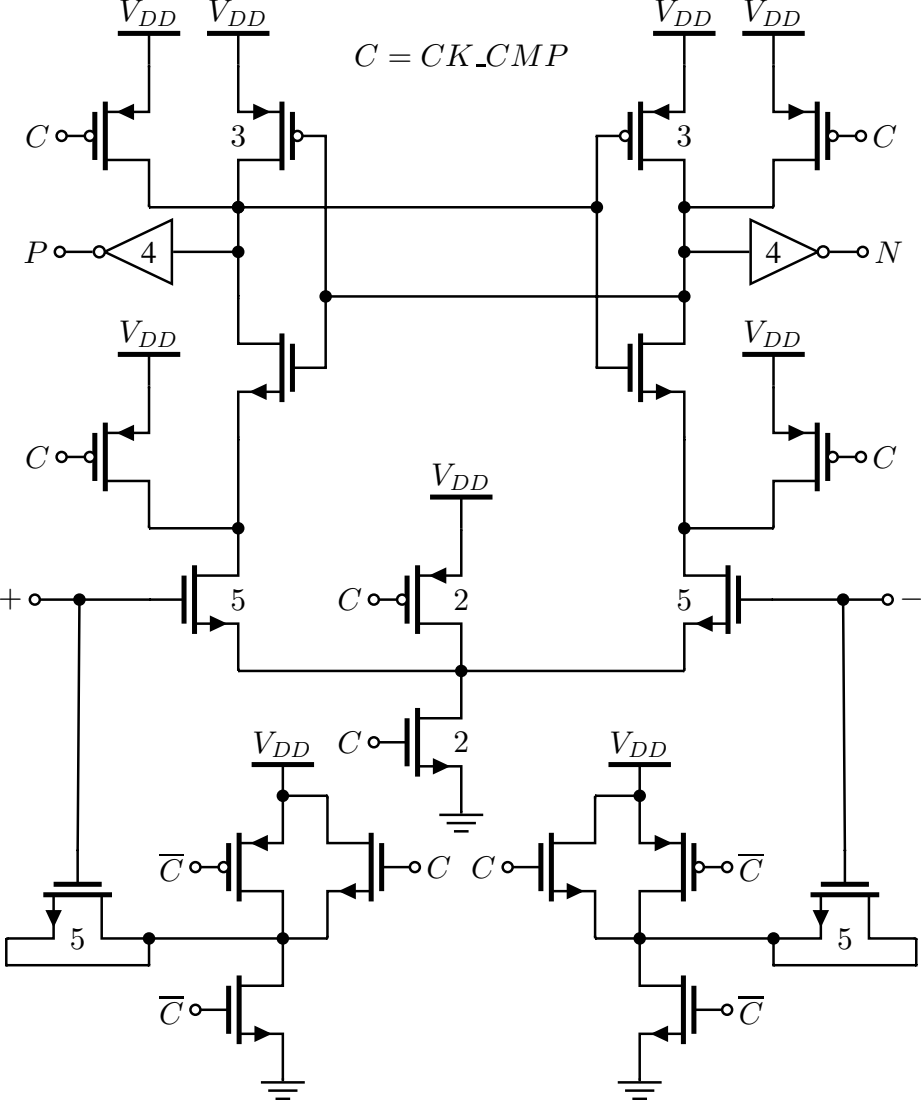
[picture p32: page 1]
VDD
