wulffern/tt06-sar/media/wulff_fig_prior_art.pdf

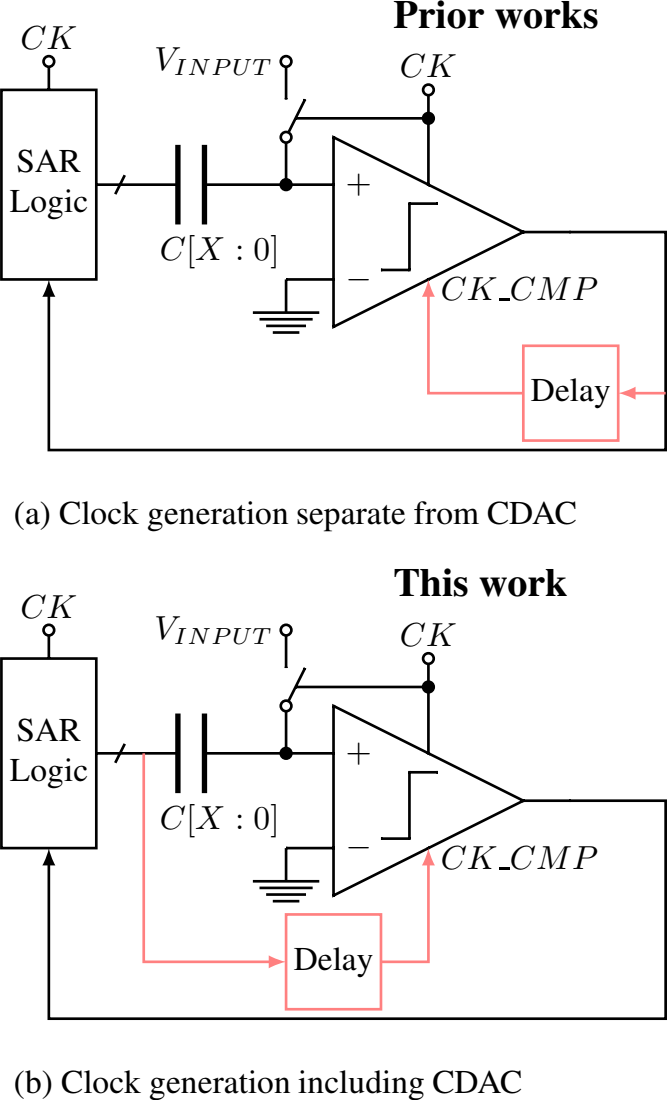
[picture p33: page 1]
Prior works; SAR Logic; VINP UT; CK CMP; Delay; This work

(a) Clock generation separate from CDAC

(b) Clock generation including CDAC
