wulffern/tt06-sar/(commit log)

2024-02-19 Added TB
    [TT06_SAR.sch]
2024-02-19 updated name of top module
    [tt_um_TT06_SAR_wulffern.sch]
2024-02-20 Added verilog
    [tt_um_TT06_SAR_wulffern.sch]
2024-02-23 LVS clean
    [tt_um_TT06_SAR_wulffern.sch]
2024-02-23 updated sar
    [tt_um_TT06_SAR_wulffern.sch]
2024-02-26 Added TIE_L for digital outputs
    [tt_um_TT06_SAR_wulffern.sch]
2024-03-17 Added supply decoupling
    [tt_um_TT06_SAR_wulffern.sch]
2024-03-18 Added decap for power
2024-03-31 Added done to output
    [tt_um_TT06_SAR_done.sch, tt_um_TT06_SAR_wulffern.sch]
2024-03-31 added docs and check that done works
    [tt_um_TT06_SAR_wulffern.sch]
2024-04-02 Moved VDD/VSS/VREF rings to sky metal1 to reduce resistance
2024-04-11 added ant stuff
    [tt_um_TT06_SAR_done.sch, tt_um_TT06_SAR_wulffern.sch]
2024-04-12 Added antenna diodes
    [tt_um_TT06_SAR_wulffern.sch]
2024-04-14 Strengthened power on BSSW. BSSW power now comes from DECAP
2024-04-18 flipped the sign of the input 0 is the positive input
    [project.v]
2024-11-05 Added note on 0 V common mode
2024-11-08 Added pkl files
    [sar.csv]
